mihaigalos/DotPhat/(list of files, cad)

Other CAD files:
cases/DotPhat.blend
