mihaigalos/DotPhat/hardware/DotPhat.brd

## EAGLE design hardware/DotPhat.brd (2018-06-09)

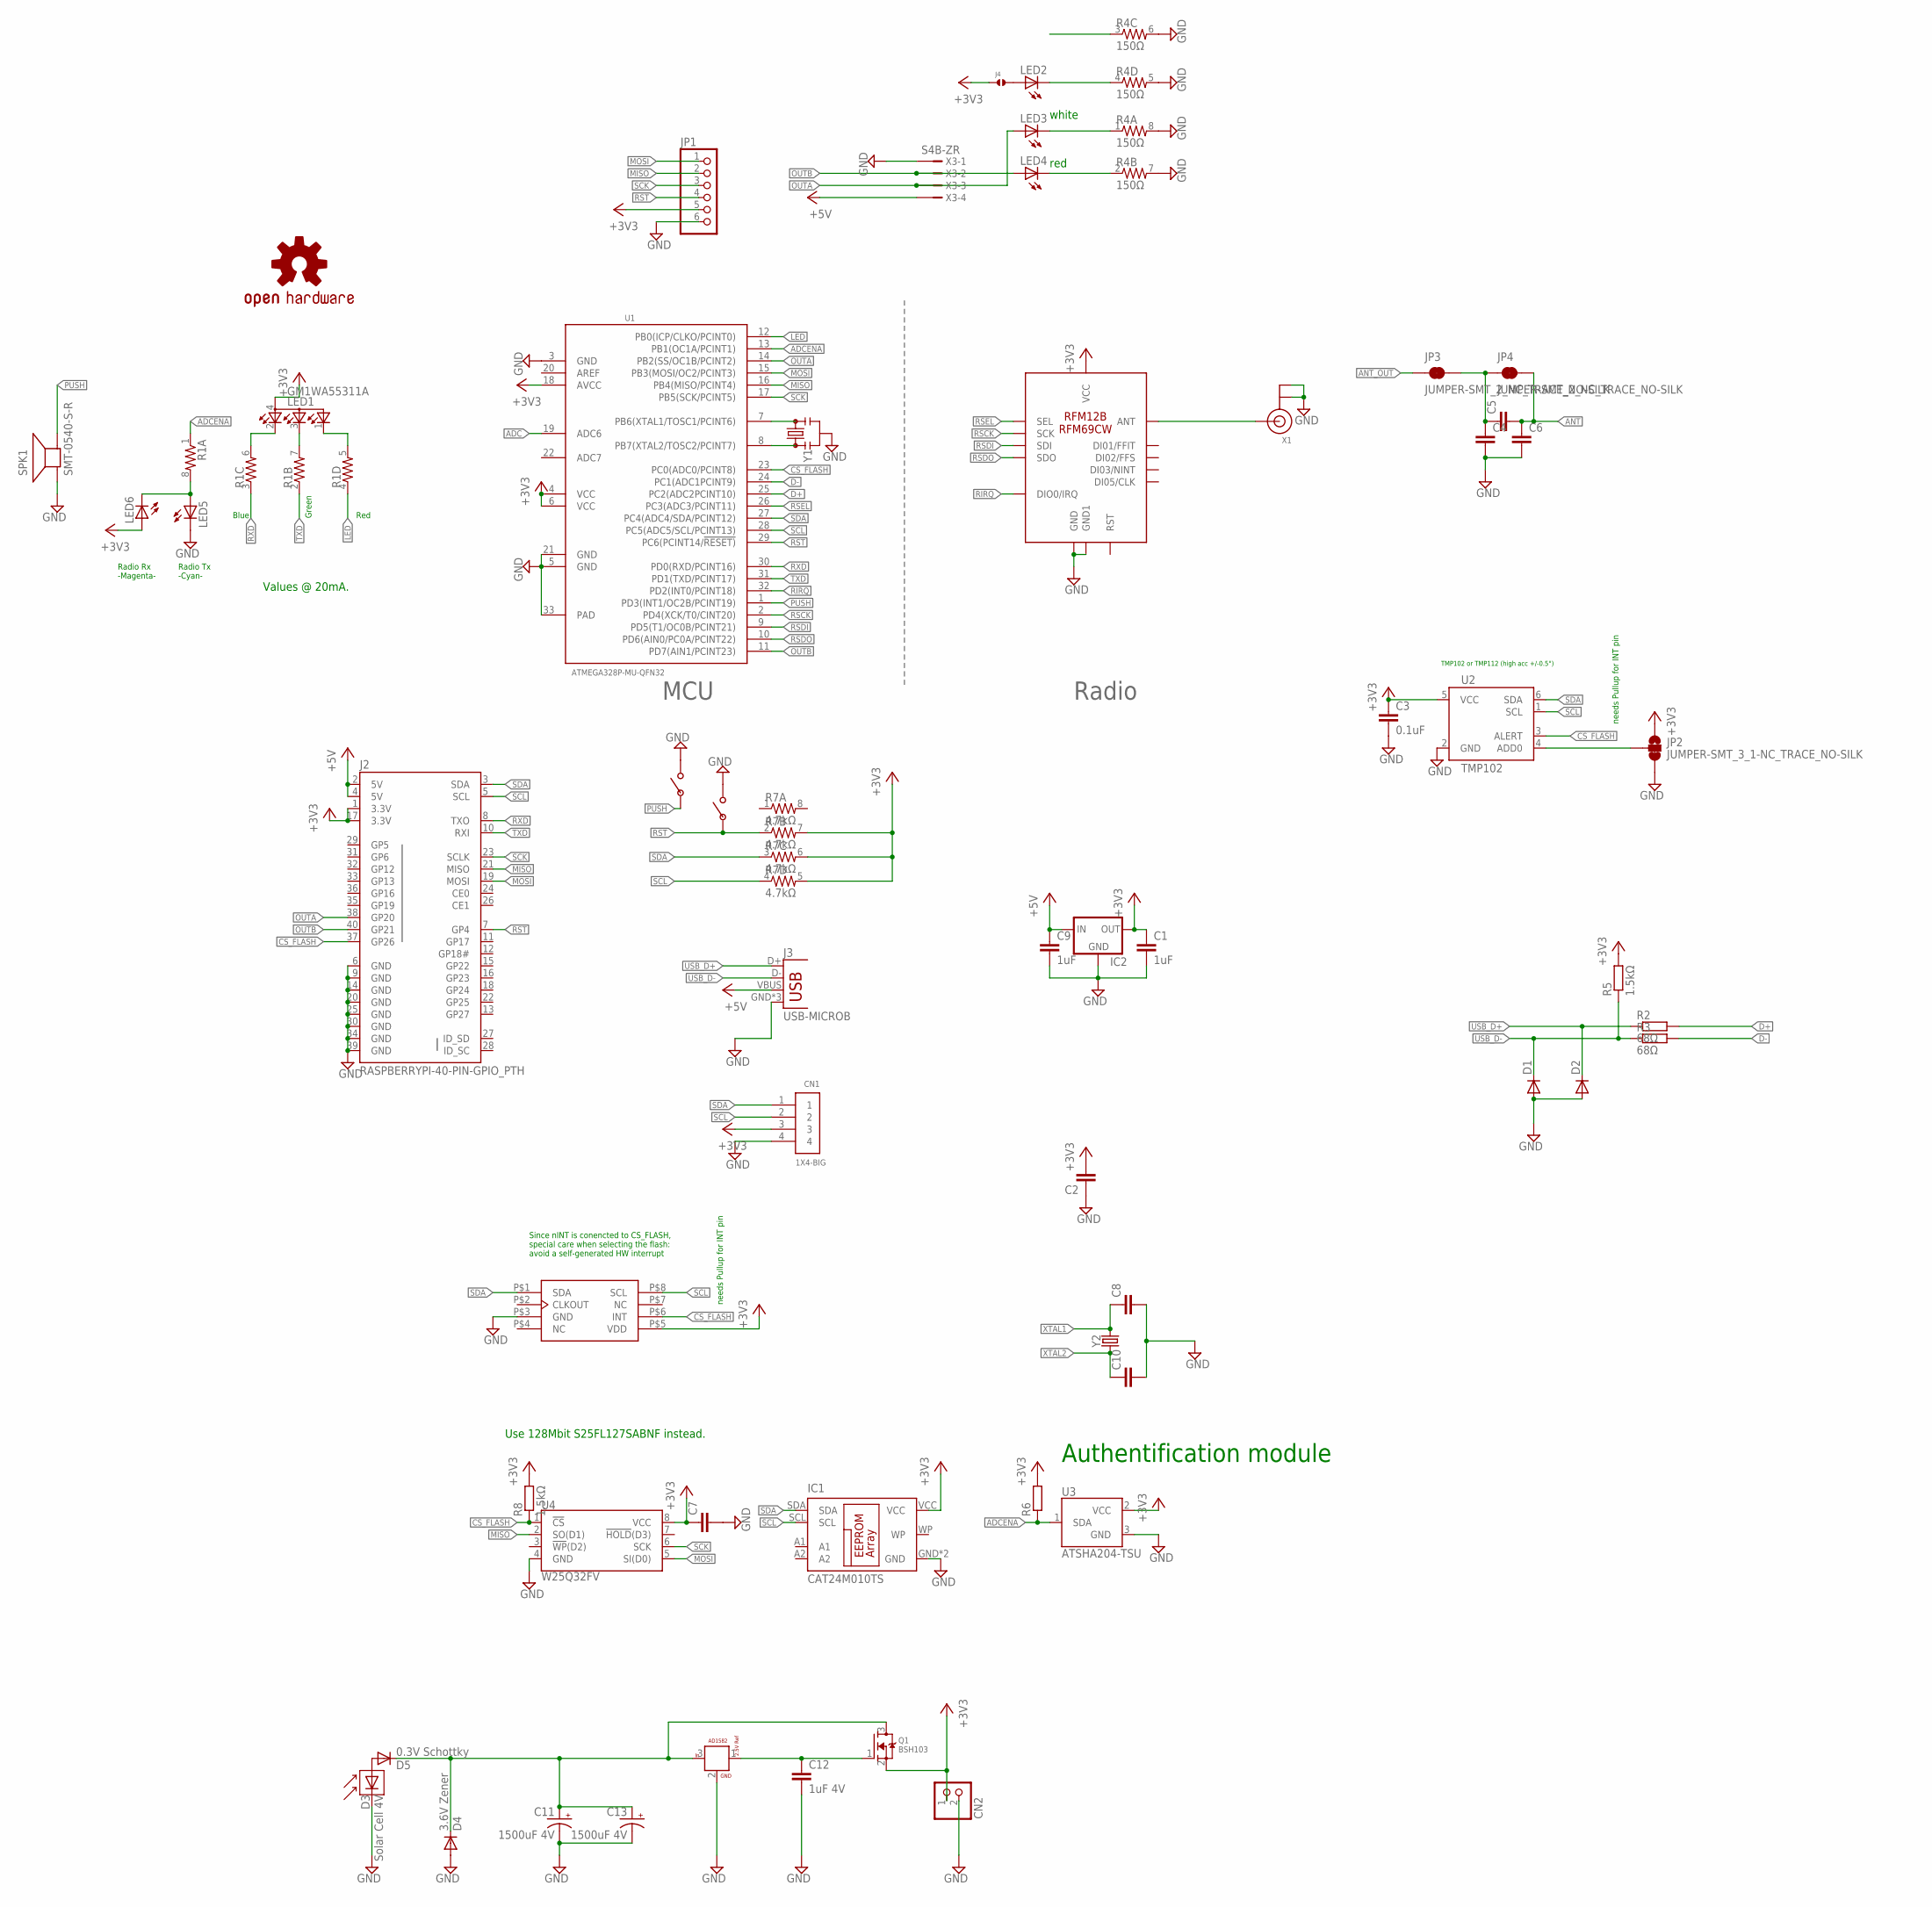
[picture p1: schematic DotPhat.sch]

Parts:
C1, C9: 1uF; C0603
C2: C-EUC3216; C3216
C3: 0.1uF; C0603
C4, C5, C6, C7: C-EUC0603; C0603
C8, C10: C-EUC0402; C0402
C11, C13: 1500uF 4V; CT7343
C12: 1uF 4V; C0603
CN1: 1X4-BIG; 1X04-BIG
CN2: JST_2PIN-SMT-RA; JST-PH-2-SMT-RA
D1, D2: DIODE-SOD523; SOD523
D3: Solar Cell 4V; SOLARBIT-12X1
D4: 3.6V Zener; SOD523
D5: 0.3V Schottky; SOD523
IC1: CAT24M010TS; TSSOP8
IC2: MCP1700TT; SOT-23
J2: RASPBERRYPI-40-PIN-GPIO_PTH; 2X20_SHROUDED
J3: USB-MICROB
J4: SOLDERJUMPER.2.MED; 2.MED
JP1: PINHD-1X6; 1X06
JP2: JUMPER-SMT_3_1-NC_TRACE_NO-SILK; SMT-JUMPER_3_1-NC_TRACE_NO-SILK
JP3, JP4: JUMPER-SMT_2_NC_TRACE_NO-SILK; SMT-JUMPER_2_NC_TRACE_NO-SILK
LED1: GM1WA55311A
LED2, LED3, LED4, LED5, LED6: LED0603; LED-0603
LOGO1: OSHW-LOGOS; OSHW-LOGO-S
Q1: BSH103; SOT23
R1: RESISTOR-ARRAY0603-ARV; 0603-ARV
R2, R3: 68Ω; R0603
R4: 150Ω; 0603-ARV
R5, R8: 1.5kΩ; R0603
R6: R-EU_R0603; R0603
R7: 4.7kΩ; 0603-ARV
SPK1: SMT-0540-S-R
U1: ATMEGA328P-MU-QFN32; QFN32G-0.5-5X5MM
U2: TMP102; SOT563
U3: ATSHA204-TSU; SOT23-3
U4: W25Q32FV; WSON8-6X5MM
U$1: RFM12B/69CW
U$2, U$3: PUSHBUTTON_4X2.5
U$4: AD1582; SOT23
X1: ANTENNA_U.FL; U.FL
X2: MC-RTC-RV-4162-C7-I2C; MC-RTC-C7
X3: S4B-ZR
Y1: RESONATORSMD-3.2X1.3; RESONATOR-SMD-3.2X1.3
Y2: CRYSTALSMD-3.2X1.5; CRYSTAL-SMD-3.2X1.5MM

Connections:
+3V3: C1.1, C2.2, C3.1, C7.1, CN1.3, CN2.1 (2), IC1.VCC, IC2.2 (OUT), J2.1 (3.3V), J2.17 (3.3V), J4.1, JP1.5, JP2.1, LED1.4 (A), LED6.A, Q1.2 (S), R5.2, R6.2, R7.5 (2), R7.6 (2), R7.7 (2), R8.2, U1.4 (VCC), U1.6 (VCC), U1.18 (AVCC), U2.5 (VCC), U3.2 (VCC), U4.8 (VCC), U$1.VDD (VCC), X2.P$5 (VDD)
+5V: C9.1, IC2.3 (IN), J2.2 (5V), J2.4 (5V), J3.VBUS, X3.4
ADC: U1.19 (ADC6)
ADCENA: R1.1, R6.1, U1.13 (PB1(OC1A/PCINT1)), U3.1 (SDA)
ANT: C5.2, C6.1, JP4.2
ANT_OUT: JP3.1, U$1.ANT, X1.3 (SIGNAL)
CAPS_VCC: C11.+, C13.+, D4.C, D5.C, Q1.3 (D), U$4.3
CS_FLASH: J2.37 (GP26), R8.1, U1.23 (PC0(ADC0/PCINT8)), U2.3 (ALERT), U4.1 (!CS!), X2.P$6 (INT)
D+: R2.2, U1.25 (PC2(ADC2PCINT10))
D-: R3.2, U1.24 (PC1(ADC1PCINT9))
GND: C1.2, C2.1, C3.2, C4.2, C6.2, C7.2, C8.2, C9.2, C10.2, C11.-, C12.2, C13.-, CN1.4, CN2.2 (1), D1.A, D2.A, D3.- (C), D4.A, IC1.GND, IC1.NC (GND), IC2.1 (GND), J2.6 (GND), J2.9 (GND), J2.14 (GND), J2.20 (GND), J2.25 (GND), J2.30 (GND), J2.34 (GND), J2.39 (GND), J3.GND, J3.MT1 (GND), J3.MT2 (GND), JP1.6, JP2.3, LED5.C, R4.5 (2), R4.6 (2), R4.7 (2), R4.8 (2), SPK1.- (+), U1.3 (GND), U1.5 (GND), U1.21 (GND), U1.33 (PAD), U2.2 (GND), U3.3 (GND), U4.4 (GND), U$1.GND, U$1.GND1, U$2.P$2, U$3.P$2, U$4.2, X1.1 (GND), X1.2 (GND), X2.P$3 (GND), X3.1, Y1.2
LED: R1.4 (1), U1.12 (PB0(ICP/CLKO/PCINT0))
MISO: J2.21 (MISO), JP1.2, U1.16 (PB4(MISO/PCINT4)), U4.2 (SO(D1))
MOSFET: C12.1, Q1.1 (G), U$4.1
MOSI: J2.19 (MOSI), JP1.1, U1.15 (PB3(MOSI/OC2/PCINT3)), U4.5 (SI(D0))
unnamed: LED1.3 (CBLUE), R1.7 (2)
unnamed: LED3.C, R4.1
unnamed: C4.1, C5.1, JP3.2, JP4.1
unnamed: LED1.2 (CRED), R1.6 (2)
unnamed: D3.+ (A), D5.A
unnamed: U1.7 (PB6(XTAL1/TOSC1/PCINT6)), Y1.3
unnamed: LED2.C, R4.4 (1)
unnamed: U1.8 (PB7(XTAL2/TOSC2/PCINT7)), Y1.1
unnamed: LED4.C, R4.2 (1)
unnamed: JP2.2, U2.4 (ADD0)
unnamed: J4.2, LED2.A
unnamed: LED5.A, LED6.C, R1.8 (2)
unnamed: LED1.1 (CGREEN), R1.5 (2)
OUTA: J2.38 (GP20), LED3.A, U1.14 (PB2(SS/OC1B/PCINT2)), X3.3
OUTB: J2.40 (GP21), LED4.A, U1.11 (PD7(AIN1/PCINT23)), X3.2
PUSH: SPK1.+ (-), U1.1 (PD3(INT1/OC2B/PCINT19)), U$3.P$1
RIRQ: U1.32 (PD2(INT0/PCINT18)), U$1.IRQ (DIO0/IRQ)
RSCK: U1.2 (PD4(XCK/T0/CINT20)), U$1.SCK
RSDI: U1.9 (PD5(T1/OC0B/PCINT21)), U$1.SDI
RSDO: U1.10 (PD6(AIN0/PC0A/PCINT22)), U$1.SDO
RSEL: U1.26 (PC3(ADC3/PCINT11)), U$1.SEL
RST: J2.7 (GP4), JP1.4, R7.2 (1), U1.29 (PC6(PCINT14/!RESET)), U$2.P$1
RXD: J2.8 (TXO), R1.3 (1), U1.30 (PD0(RXD/PCINT16))
SCK: J2.23 (SCLK), JP1.3, U1.17 (PB5(SCK/PCINT5)), U4.6 (SCK)
SCL: CN1.2, IC1.SCL, J2.5 (SCL), R7.4 (1), U1.28 (PC5(ADC5/SCL/PCINT13)), U2.1 (SCL), X2.P$8 (SCL)
SDA: CN1.1, IC1.SDA, J2.3 (SDA), R7.3 (1), U1.27 (PC4(ADC4/SDA/PCINT12)), U2.6 (SDA), X2.P$1 (SDA)
TXD: J2.10 (RXI), R1.2 (1), U1.31 (PD1(TXD/PCINT17))
USB_D+: D2.C, J3.D+, R2.1
USB_D-: D1.C, J3.D-, R3.1, R5.1
XTAL1: C8.1, Y2.P$2 (2)
XTAL2: C10.1, Y2.P$1 (1)

Notes on the sheet:
MCU
Radio
Values @ 20mA.
Blue
Green
Red
TMP102 or TMP112 (high acc +/-0.5°)
Authentification module
white
red
Use 128Mbit S25FL127SABNF instead.
Since nINT is conencted to CS_FLASH, special care when selecting the flash: avoid a self-generated HW interrupt
needs Pullup for INT pin
Radio Rx -Magenta-
Radio Tx -Cyan-

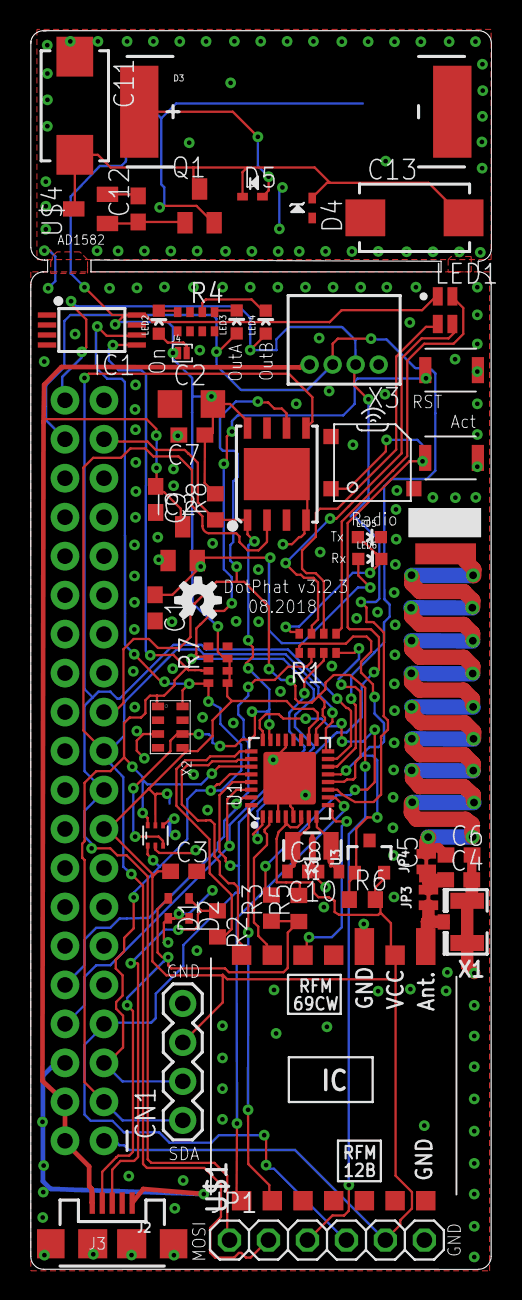
[picture p2: board DotPhat.brd from above]

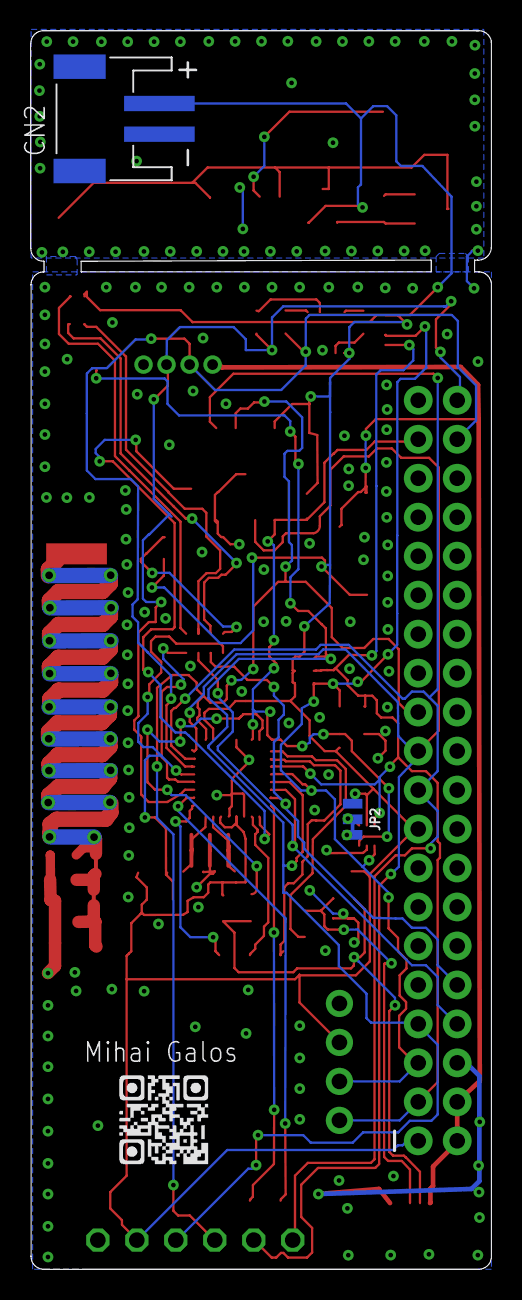
[picture p3: board DotPhat.brd from below]

Board: 2 copper layers, 30.0 x 80.7 mm, 59 parts (2 on the bottom side), 45 nets.
