mihaigalos/DotPhat/software/DotPhat/config.h

#pragma once

static constexpr auto kOwnId = 0x10;
static constexpr auto kMaxRfPower = 31;

static constexpr uint8_t kRedLed = 8;
static constexpr uint8_t kBlueLed = 0;
static constexpr uint8_t kGreenLed = 1;

static constexpr uint8_t kOutABLed = 10;

static constexpr uint8_t kTRXLed = 9;

static constexpr uint8_t kInterruptPin = 3;
static constexpr uint8_t kClockPrescaler = CLOCK_PRESCALER_16;

enum class ApplicationsStatus {
    Unknown,
    Idle,
    RadioSend,
    RadioSendPeriodic,
    RadioReceive,
    DumpEeprom,
    VoltageToLeds,
    TemperatureToLeds
};

ApplicationsStatus app_status;
