mihaigalos/DotPhat/(commit log)

2017-10-06 Initial version
    [DotPhat.brd, DotPhat.sch]
2017-10-06 Add 2 out JST connectors, solid GND vias
    [DotPhat.brd, DotPhat.sch]
2017-10-07 Replace JST2 with JST4, add leds for channels
    [DotPhat.brd, DotPhat.sch]
2017-10-15 Swap 5V and GND for the JST to match cable color
    [DotPhat.brd, DotPhat.sch]
2017-10-21 Add microusb
    [DotPhat.brd, DotPhat.sch]
2017-10-21 Add I2C
    [DotPhat.brd, DotPhat.sch]
2017-10-21 Improving GND
    [DotPhat.brd]
2017-10-21 Add radio led
    [DotPhat.brd, DotPhat.sch]
2017-10-21 Add HexId, ISM Bands
    [DotPhat.brd]
2017-10-21 Make JST compatible with generic relays
    [DotPhat.brd, DotPhat.sch]
2017-10-21 Update with RPi lib with no tPlace
    [DotPhat.brd, DotPhat.sch]
2017-10-21 Add mandatory 5V-3.3V capless regulator for USB power
    [DotPhat.brd, DotPhat.sch]
2017-10-22 Add filter cap at 3.3V regulator out pin
    [DotPhat.brd, DotPhat.sch]
2017-10-22 Replace RGB resistors for array
    [DotPhat.brd, DotPhat.sch]
2017-10-22 Add TMP112 temperature sensor
    [DotPhat.brd, DotPhat.sch]
2017-11-03 Add USB programming connections
    [DotPhat.brd, DotPhat.sch]
2017-11-03 Update version info
    [DotPhat.brd]
2017-11-03 Add rounded corners
    [DotPhat.brd]
2017-11-04 Add I2C E2PROM
    [DotPhat.brd, DotPhat.sch]
2017-11-05 Move vias away from R array
    [DotPhat.brd]
2017-11-05 Update labels
    [DotPhat.brd]
2017-11-05 Add CryptoAuthentication module
    [DotPhat.brd, DotPhat.sch]
2017-11-05 Reposition new components
    [DotPhat.brd]
2017-11-07 Make USB_D+ and USB_D- part of the same port. Required for Micronucleus.
    [DotPhat.brd, DotPhat.sch]
2017-11-07 Updating version
    [DotPhat.brd]
2017-11-08 Add pullup on SDA for crypto & bypass cap
    [DotPhat.brd, DotPhat.sch]
2017-12-26 Add PCB Antenna
    [DotPhat.brd]
2017-12-26 Add Pi-network for antenna matching
    [DotPhat.brd, DotPhat.sch]
2017-12-26 Rearrange USB and OUT connectors
    [DotPhat.brd]
2017-12-26 Update version to 1.0.0
    [DotPhat.brd]
2017-12-26 Add support for high-precision chrystal
    [DotPhat.brd, DotPhat.sch]
2017-12-26 Correct via
    [DotPhat.brd]
2017-12-28 Flip uFL to top side
    [DotPhat.brd]
2017-12-28 Switch to SMD buzzer
    [DotPhat.brd, DotPhat.sch]
2017-12-28 Reposition antenna PI-filter
    [DotPhat.brd, DotPhat.sch]
2017-12-28 Improve GND
    [DotPhat.brd]
2018-02-03 Correct short-circuit
    [DotPhat.brd]
2018-02-04 Update USB pullup to downside, 3.3V instead of 5V
    [DotPhat.brd, DotPhat.sch]
2018-02-25 Update actor leds' color in schematic
    [DotPhat.sch]
2018-03-21 Initial DotPhat case
    [DotPhat_2.0.0.blend]
2018-03-21 Add microusb and relay cuts
    [DotPhat_2.0.0.blend]
2018-03-21 Semifinal design
    [DotPhat_2.0.0.blend]
2018-03-23 Update case
    [DotPhat_2.0.0.blend]
2018-03-23 Case v2
    [DotPhat_2.0.0_v2.blend]
2018-03-23 Add revised case
    [DotPhat_2.0.0.blend, DotPhat_2.0.0_v2.blend]
2018-03-26 Add 128Mbit SPI Flash
    [DotPhat.brd, DotPhat.sch]
2018-03-30 Add RTC chip, plug irqs from sensors, flash
    [DotPhat.brd, DotPhat.sch]
2018-03-30 Switch to low quiescent LDO
    [DotPhat.brd, DotPhat.sch]
2018-03-30 Update version
    [DotPhat.brd]
2018-03-30 Drive OutX from Pi, additionally
    [DotPhat.brd, DotPhat.sch]
2018-05-03 Add jumper for power led
    [DotPhat.brd, DotPhat.sch]
2018-05-05 Add logic for sending and receiving RF. Not yet tested.
    [DotPhat.blend]
2018-05-09 Add radio activity led
    [DotPhat.brd, DotPhat.sch]
2018-05-09 Add TRx leds for radio communication, improve GND
    [DotPhat.brd, DotPhat.sch]
2018-05-12 Add push reset and action
    [DotPhat.brd, DotPhat.sch]
2018-05-16 Correct Rx led polarity
    [DotPhat.brd, DotPhat.sch]
2018-06-06 Beta: Add solar supply with caps
    [DotPhat.brd, DotPhat.sch]
2018-06-07 Beta: Simplify solar power supply
    [DotPhat.brd, DotPhat.sch]
2018-06-14 Fix send command repeat and frequency parsing
    [DotPhat.ino]
2018-07-21 PoC: Ledmenu
2018-07-21 Improve PoC for ledmenu
2018-07-22 Working implementation of 1-button menu
2018-07-24 Add I2C read handler
2018-07-27 Add I2C Callback, vcc to blinks
2018-07-30 Add I2C write byte
2018-08-01 Correct i2c read
2018-10-03 Optimize RF to leds
2018-10-05 Add support for TRX led
2018-10-05 Add temperature to rgb
2018-10-05 Add temperature fractional part
2018-11-30 Add prescaler for smooth running under 3V
2020-04-10 Replace comments with types
    [DotPhat.ino]
2020-04-10 Refactor temperature to leds to separate file
